lemonspurple/KiCad_STM_Controllerboard_v3_0/Plots/3D.png

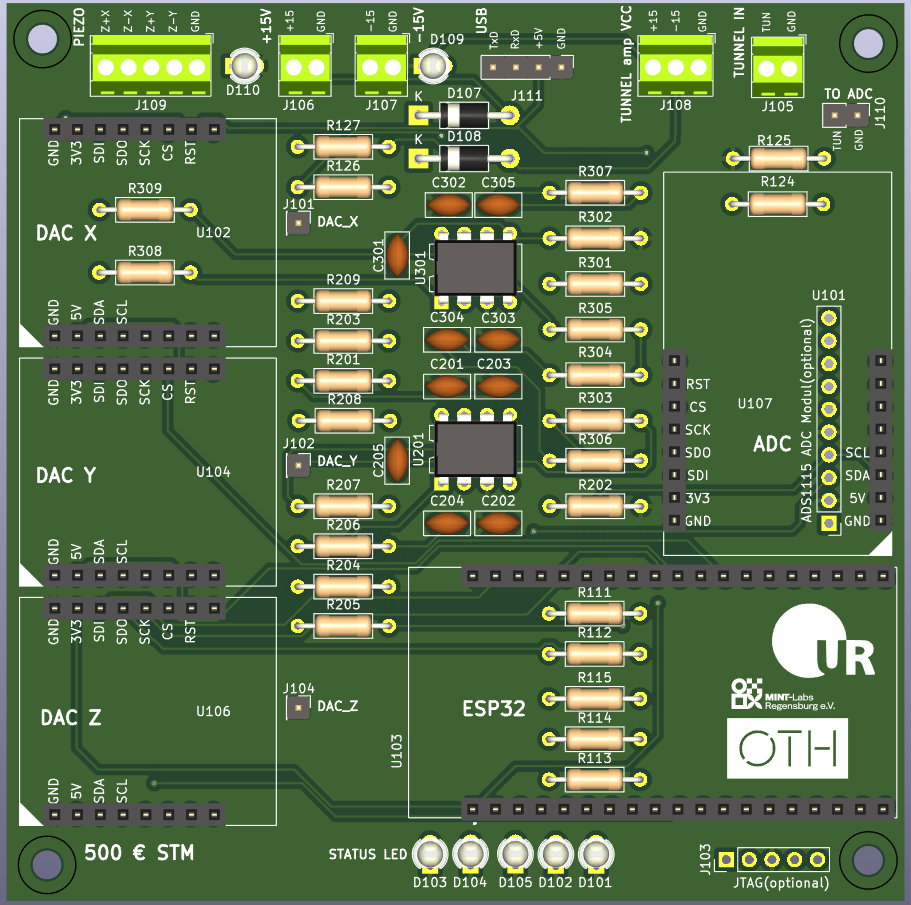
Plots/3D.png
