lemonspurple/KiCad_STM_Controllerboard_v3_0/Plots/FFab.png

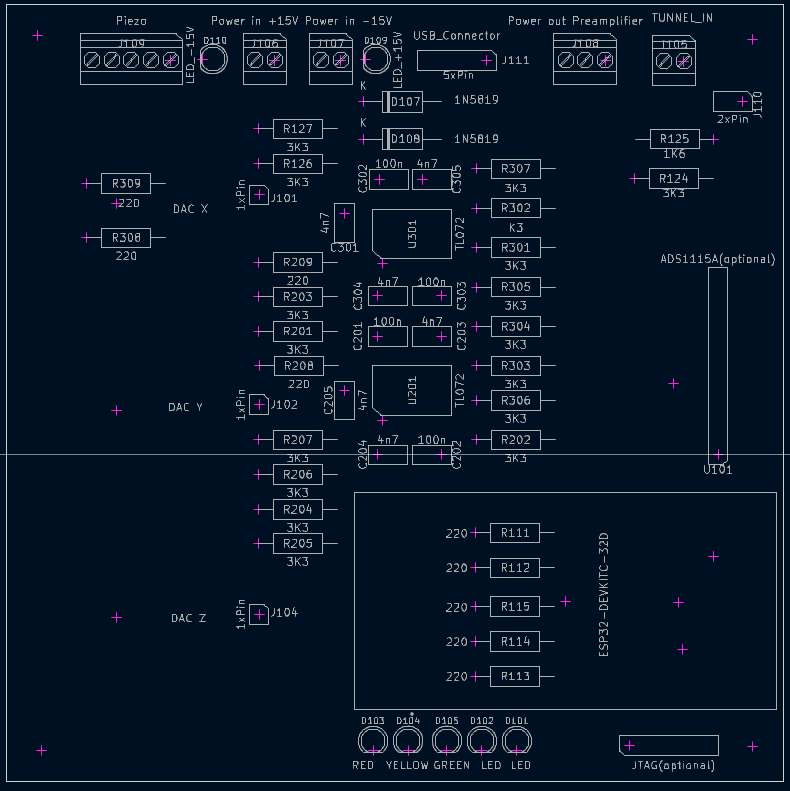
Plots/FFab.png
