lemonspurple/KiCad_STM_Controllerboard_v3_0/Plots/FFab_Fmask.png

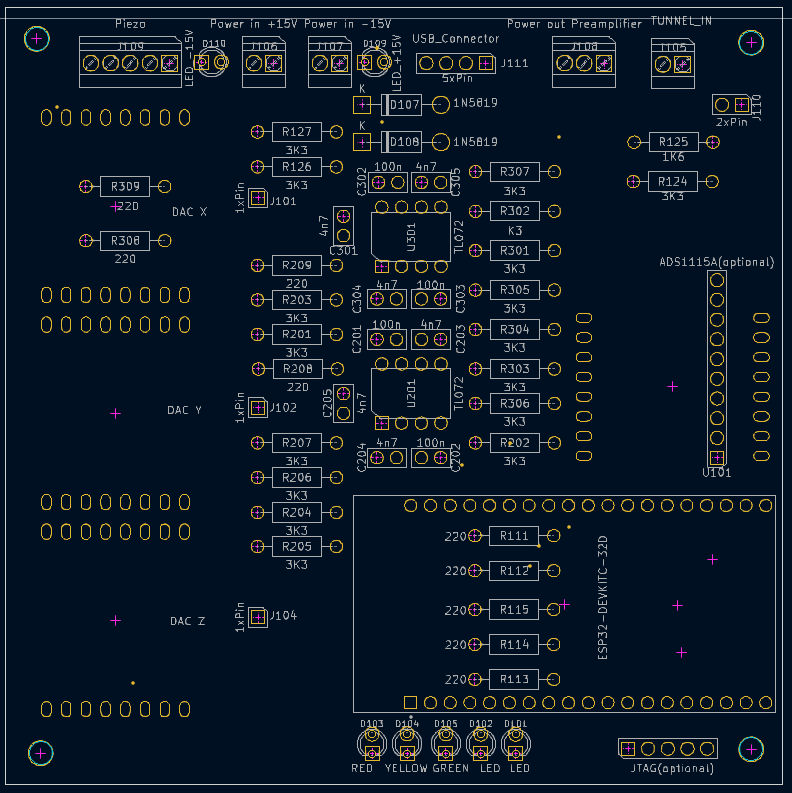
Plots/FFab_Fmask.png
