lemonspurple/KiCad_STM_Controllerboard_v3_0/Plots/Schematics.png

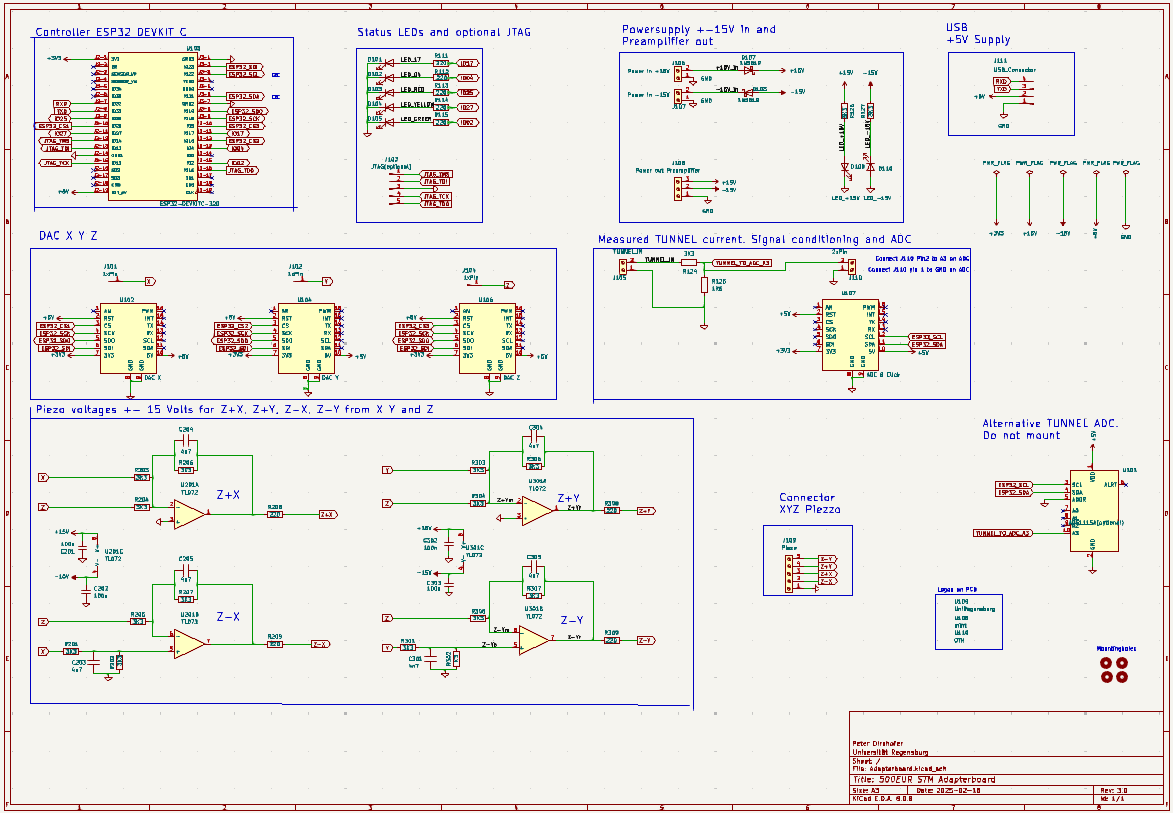
Plots/Schematics.png
