lemonspurple/KiCad_STM_Controllerboard_v3_0/Plots/Silkscreen.png

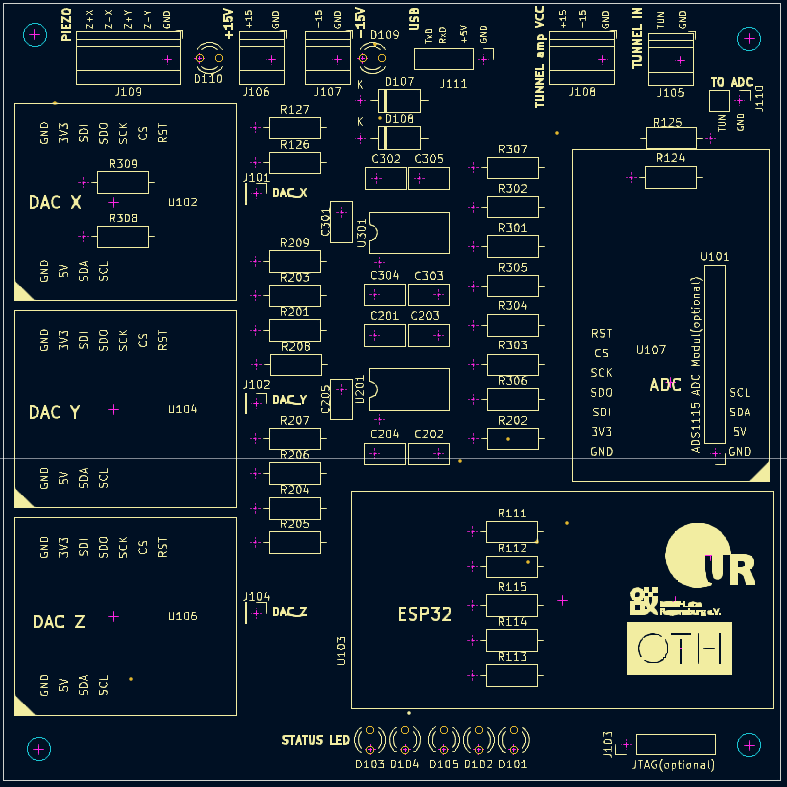
Plots/Silkscreen.png
