lemonspurple/KiCad_STM_Controllerboard_v3_0/Plots/Silkscreen_Fmask.png

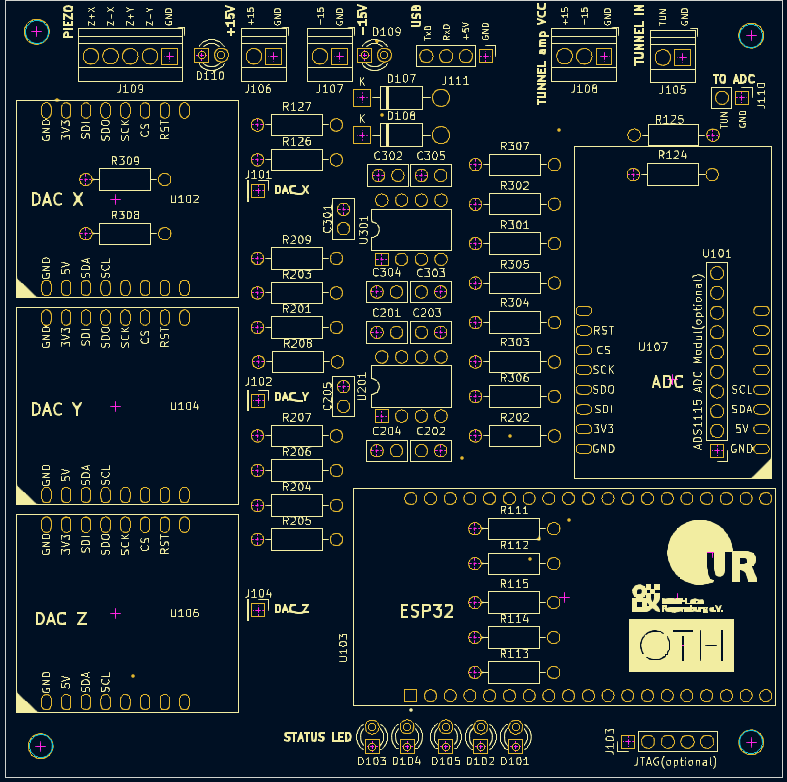
Plots/Silkscreen_Fmask.png
