lemonspurple/KiCad_STM_Controllerboard_v3_0/Adapterboard.pdf

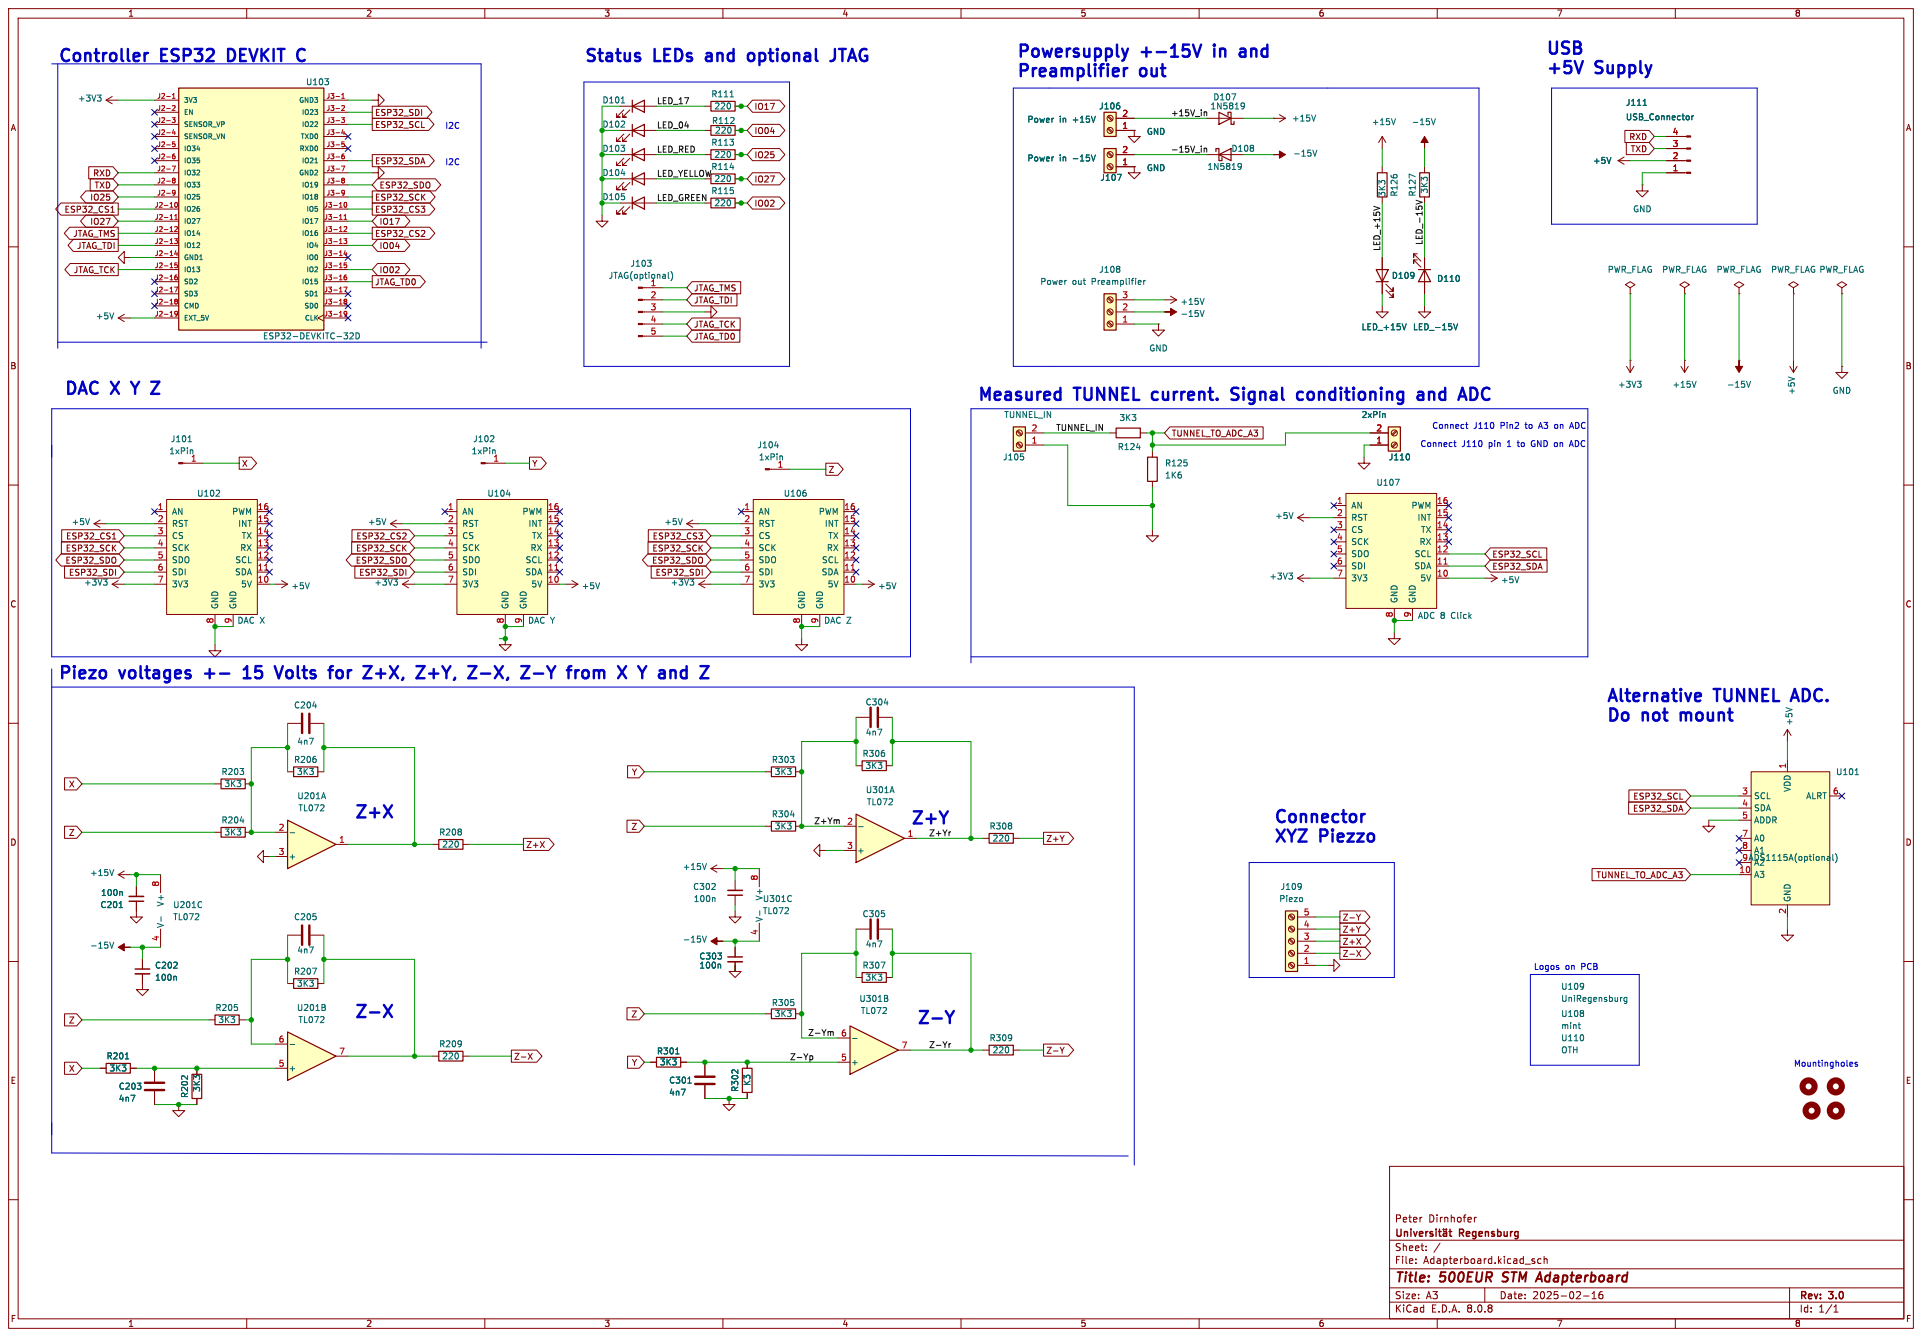
[picture p8: page 1]

Connect J110 Pin2 to A3 on ADC Z-Y

Connect J110 pin 1 to GND on ADC

INT 15 PWM 16 RST 2 CS 3 SCK 4 SDO 5 SDI 6

5V 10 SDA 11 SCL 12 RX 13 TX 14

Id: 1/1 Title: 500EUR STM Adapterboard
