lemonspurple/KiCad_STM_Controllerboard_v3_0/Adapterboard.kicad_pcb

## KiCad design Adapterboard.kicad_pcb (2025-02-21)

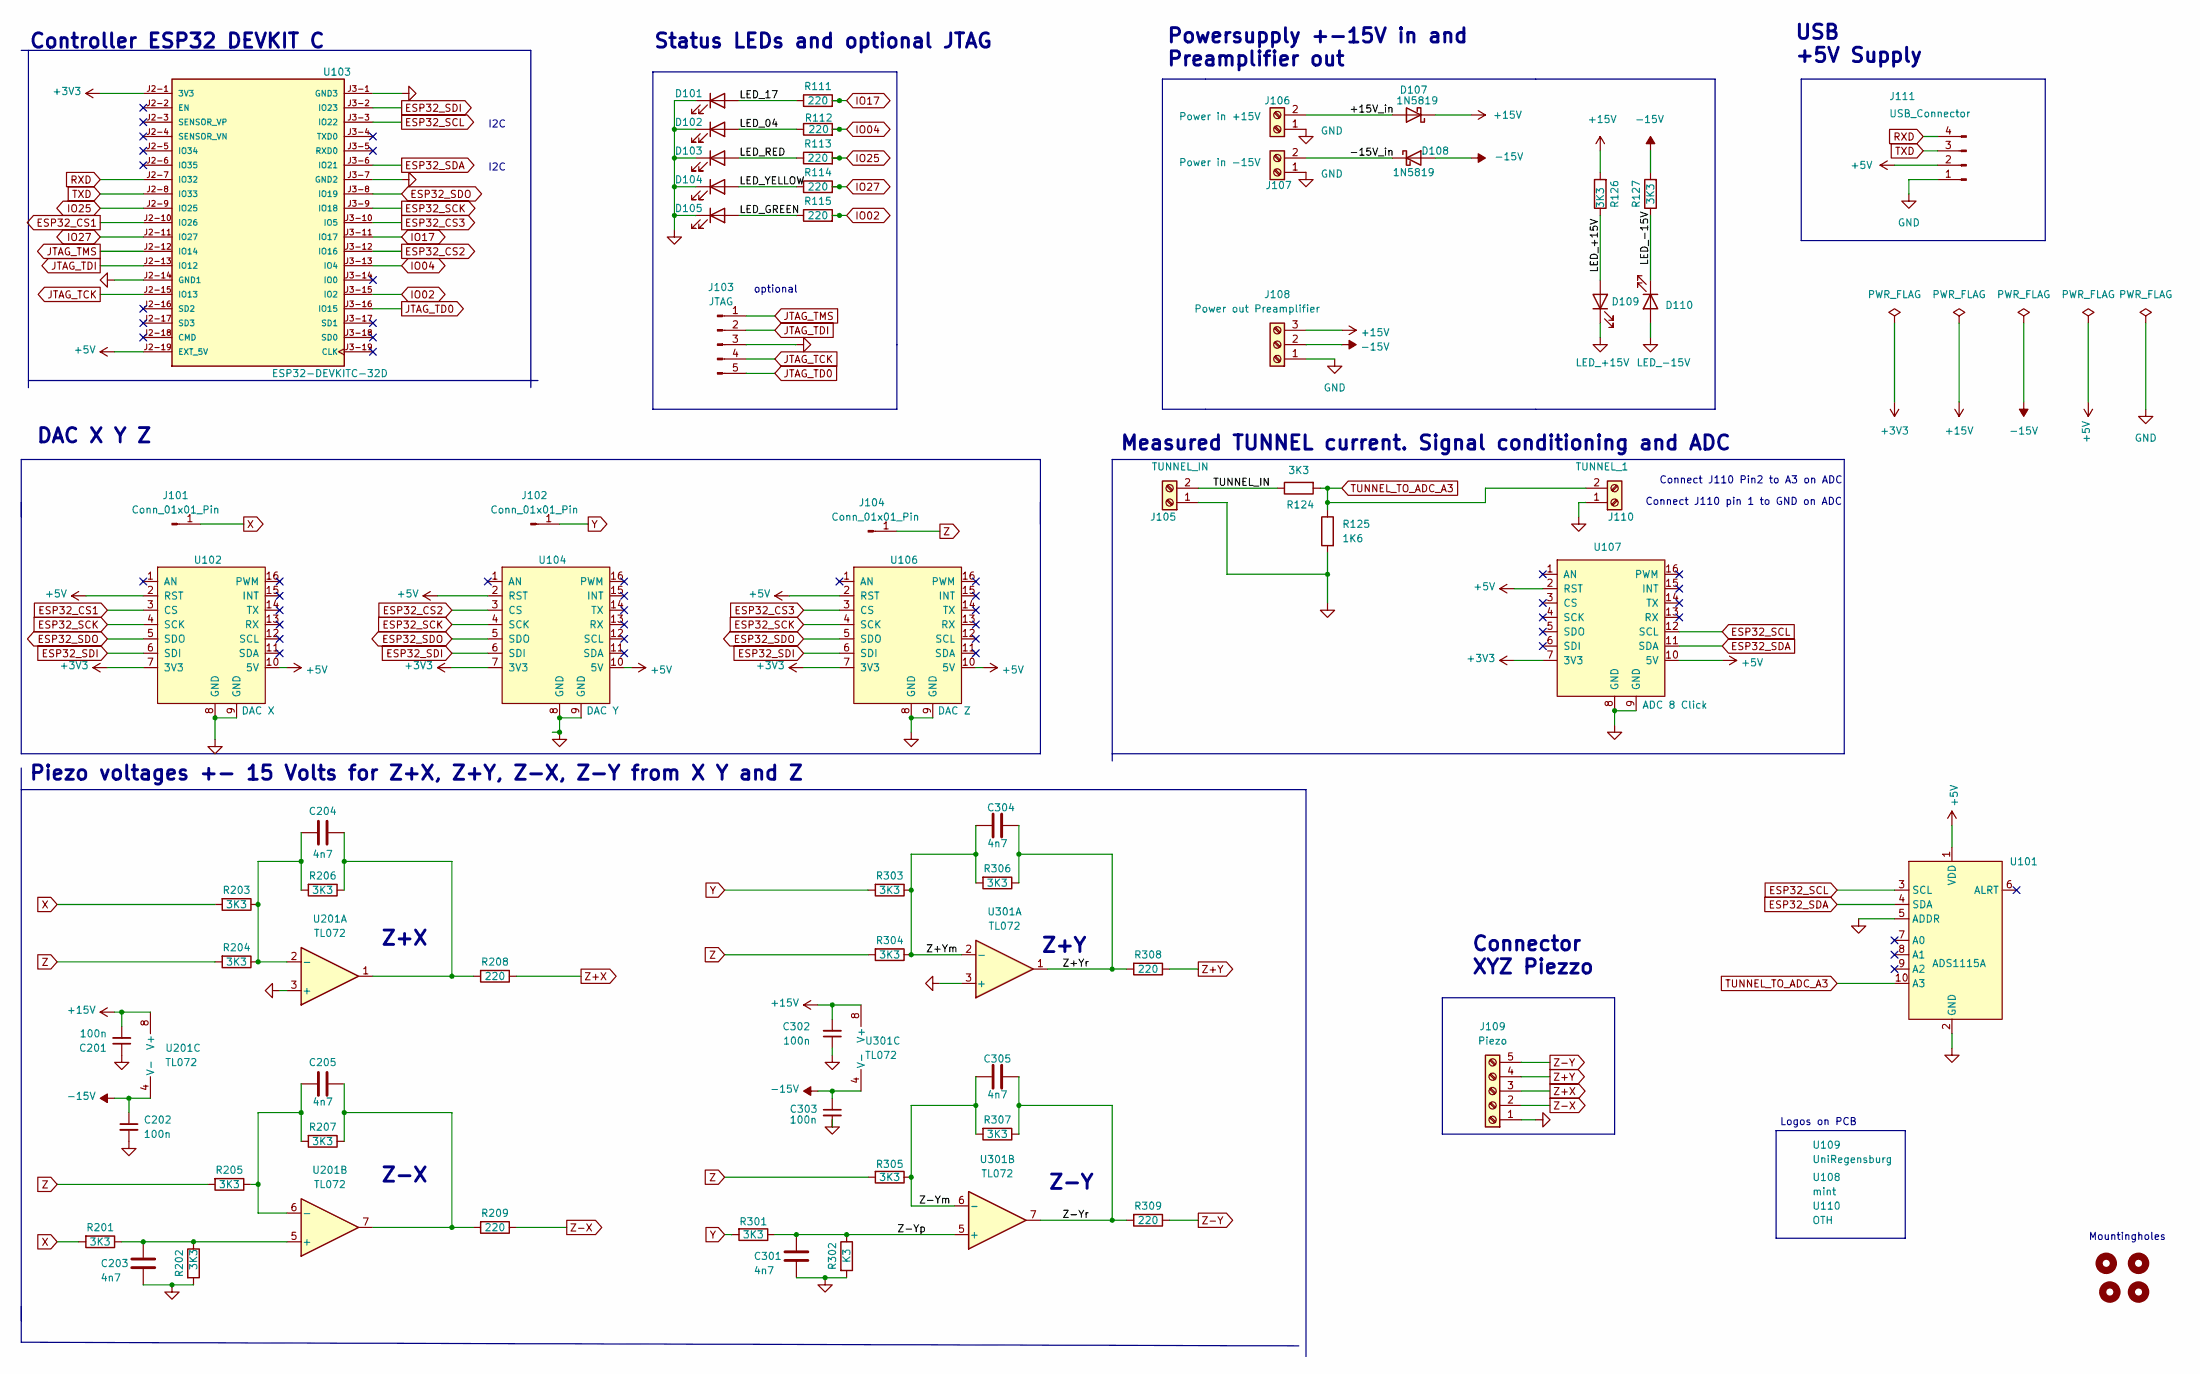
[picture p9: schematic Adapterboard.kicad_sch, 500EUR STM Adapterboard]

Parts:
C201, C202, C302, C303: 100n; C_Disc_D5.0mm_W2.5mm_P2.50mm
C203, C204, C205, C301, C304, C305: 4n7; C_Disc_D5.0mm_W2.5mm_P2.50mm
D101, D102: LED; LED_D3.0mm_Clear
D103: LED_RED; LED_D3.0mm_Clear
D104: LED_YELLOW; LED_D3.0mm_Clear
D105: LED_GREEN; LED_D3.0mm_Clear
D107, D108: 1N5819; D_DO-41_SOD81_P10.16mm_Horizontal
D109: LED_+15V; LED_D3.0mm_Clear
D110: LED_-15V; LED_D3.0mm_Clear
H101, H102, H103, H104: MountingHole; MountingHole_3.2mm_M3
J101, J102, J104: Conn_01x01_Pin; PinHeader_1x01_P2.54mm_Vertical
J103: JTAG; PinHeader_1x05_P2.54mm_Vertical
J105: TUNNEL_IN; TerminalBlock_Xinya_XY308-2.54-2P_1x02_P2.54mm_Horizontal
J106: Power in +15V; TerminalBlock_Xinya_XY308-2.54-2P_1x02_P2.54mm_Horizontal
J107: Power in -15V; TerminalBlock_Xinya_XY308-2.54-2P_1x02_P2.54mm_Horizontal
J108: Power out Preamplifier; TerminalBlock_Xinya_XY308-2.54-3P_1x03_P2.54mm_Horizontal
J109: Piezo; TerminalBlock_Xinya_XY308-2.54-5P_1x05_P2.54mm_Horizontal
J110: TUNNEL_1; PinHeader_1x02_P2.54mm_Vertical
J111: USB_Connector; PinHeader_1x04_P2.54mm_Vertical
R111, R112, R113, R114, R115, R208, R209, R308, R309: 220; R_Axial_DIN0207_L6.3mm_D2.5mm_P10.16mm_Horizontal
R124, R126, R127, R201, R202, R203, R204, R205, R206, R207, R301, R303, R304, R305, R306, R307: 3K3; R_Axial_DIN0207_L6.3mm_D2.5mm_P10.16mm_Horizontal
R125: 1K6; R_Axial_DIN0207_L6.3mm_D2.5mm_P10.16mm_Horizontal
R302: K3; R_Axial_DIN0207_L6.3mm_D2.5mm_P10.16mm_Horizontal
U101: ADS1115A; PinHeader_1x10_P2.54mm_Vertical
U102: DAC X; Mikroe_Socket_DAC_2_Click
U103: ESP32-DEVKITC-32D; MODULE_ESP32-DEVKITC-32D; PARTREV V4
U104: DAC Y; Mikroe_Socket_DAC_2_Click
U106: DAC Z; Mikroe_Socket_DAC_2_Click
U107: ADC 8 Click; Mikroe_Socket_ADC_8_Click
U108: mint
U109: UniRegensburg; ur
U110: OTH; oth
U201, U301: TL072; DIP-8_W7.62mm

Connections:
+3V3: U102.7 (3V3), U103.J2-1 (3V3), U104.7 (3V3), U106.7 (3V3), U107.7 (3V3)
+5V: J111.2, U101.1 (VDD), U102.2 (RST), U102.10 (5V), U103.J2-19 (EXT_5V), U104.2 (RST), U104.10 (5V), U106.2 (RST), U106.10 (5V), U107.2 (RST), U107.10 (5V)
+15V: C201.2, C302.2, D107.1 (K), J108.3, R126.2, U201.8 (V+), U301.8 (V+)
-15V: C202.1, C303.1, D108.2 (A), J108.2, R127.2, U201.4 (V-), U301.4 (V-)
/+15V_in: D107.2 (A), J106.2
/-15V_in: D108.1 (K), J107.2
/LED_04: D102.2 (A), R112.1
/LED_17: D101.2 (A), R111.1
/LED_+15V: D109.2 (A), R126.1
/LED_-15V: D110.1 (K), R127.1
/LED_GREEN: D105.2 (A), R115.1
/LED_RED: D103.2 (A), R113.1
/LED_YELLOW: D104.2 (A), R114.1
/TUNNEL_IN: J105.2, R124.1
/Z+Ym: C304.2, R303.1, R304.1, R306.2, U301.2 (-)
/Z+Yr: C304.1, R306.1, R308.2, U301.1
/Z-Ym: C305.2, R305.1, R307.2, U301.6 (-)
/Z-Yp: C301.1, R301.1, R302.1, U301.5 (+)
/Z-Yr: C305.1, R307.1, R309.2, U301.7
ESP32_CS1: U102.3 (CS), U103.J2-10 (IO26)
ESP32_CS2: U103.J3-12 (IO16), U104.3 (CS)
ESP32_CS3: U103.J3-10 (IO5), U106.3 (CS)
ESP32_SCK: U102.4 (SCK), U103.J3-9 (IO18), U104.4 (SCK), U106.4 (SCK)
ESP32_SCL: U101.3 (SCL), U103.J3-3 (IO22), U107.12 (SCL)
ESP32_SDA: U101.4 (SDA), U103.J3-6 (IO21), U107.11 (SDA)
ESP32_SDI: U102.6 (SDI), U103.J3-2 (IO23), U104.6 (SDI), U106.6 (SDI)
ESP32_SDO: U102.5 (SDO), U103.J3-8 (IO19), U104.5 (SDO), U106.5 (SDO)
GND: C201.1, C202.2, C203.2, C301.2, C302.1, C303.2, D101.1 (K), D102.1 (K), D103.1 (K), D104.1 (K), D105.1 (K), D109.1 (K), D110.2 (A), J103.3, J105.1, J106.1, J107.1, J108.1, J109.1, J110.1, J111.1, R125.2, R202.2, R302.2, U101.2 (GND), U101.5 (ADDR), U102.8 (GND), U102.9 (GND), U103.J2-14 (GND1), U103.J3-1 (GND3), U103.J3-7 (GND2), U104.8 (GND), U104.9 (GND), U106.8 (GND), U106.9 (GND), U107.8 (GND), U107.9 (GND), U201.3 (+), U301.3 (+)
IO02: R115.2, U103.J3-15 (IO2)
IO04: R112.2, U103.J3-13 (IO4)
IO17: R111.2, U103.J3-11 (IO17)
IO25: R113.2, U103.J2-9 (IO25)
IO27: R114.2, U103.J2-11 (IO27)
JTAG_TCK: J103.4, U103.J2-15 (IO13)
JTAG_TD0: J103.5, U103.J3-16 (IO15)
JTAG_TDI: J103.2, U103.J2-13 (IO12)
JTAG_TMS: J103.1, U103.J2-12 (IO14)
unnamed: C204.1, R206.1, R208.2, U201.1
unnamed: C205.1, R207.1, R209.2, U201.7
unnamed: C204.2, R203.1, R204.1, R206.2, U201.2 (-)
unnamed: C203.1, R201.1, R202.1, U201.5 (+)
unnamed: C205.2, R205.1, R207.2, U201.6 (-)
RXD: J111.4, U103.J2-7 (IO32)
TUNNEL_TO_ADC_A3: J110.2, R124.2, R125.1, U101.10 (A3)
TXD: J111.3, U103.J2-8 (IO33)
X: J101.1, R201.2, R203.2
Y: J102.1, R301.2, R303.2
Z: J104.1, R204.2, R205.2, R304.2, R305.2
Z+X: J109.3, R208.1
Z+Y: J109.4, R308.1
Z-X: J109.2, R209.1
Z-Y: J109.5, R309.1

Notes on the sheet:
Measured TUNNEL current. Signal conditioning and ADC
Connector XYZ Piezzo
Status LEDs and optional JTAG
I2C
Z-Y
USB +5V Supply
optional
Powersupply +-15V in and Preamplifier out
Controller ESP32 DEVKIT C
Connect J110 pin 1 to GND on ADC
Mountingholes
Piezo voltages +- 15 Volts for Z+X, Z+Y, Z-X, Z-Y from X Y and Z
Connect J110 Pin2 to A3 on ADC
Logos on PCB
DAC X Y Z
Z-X
Z+X
Z+Y

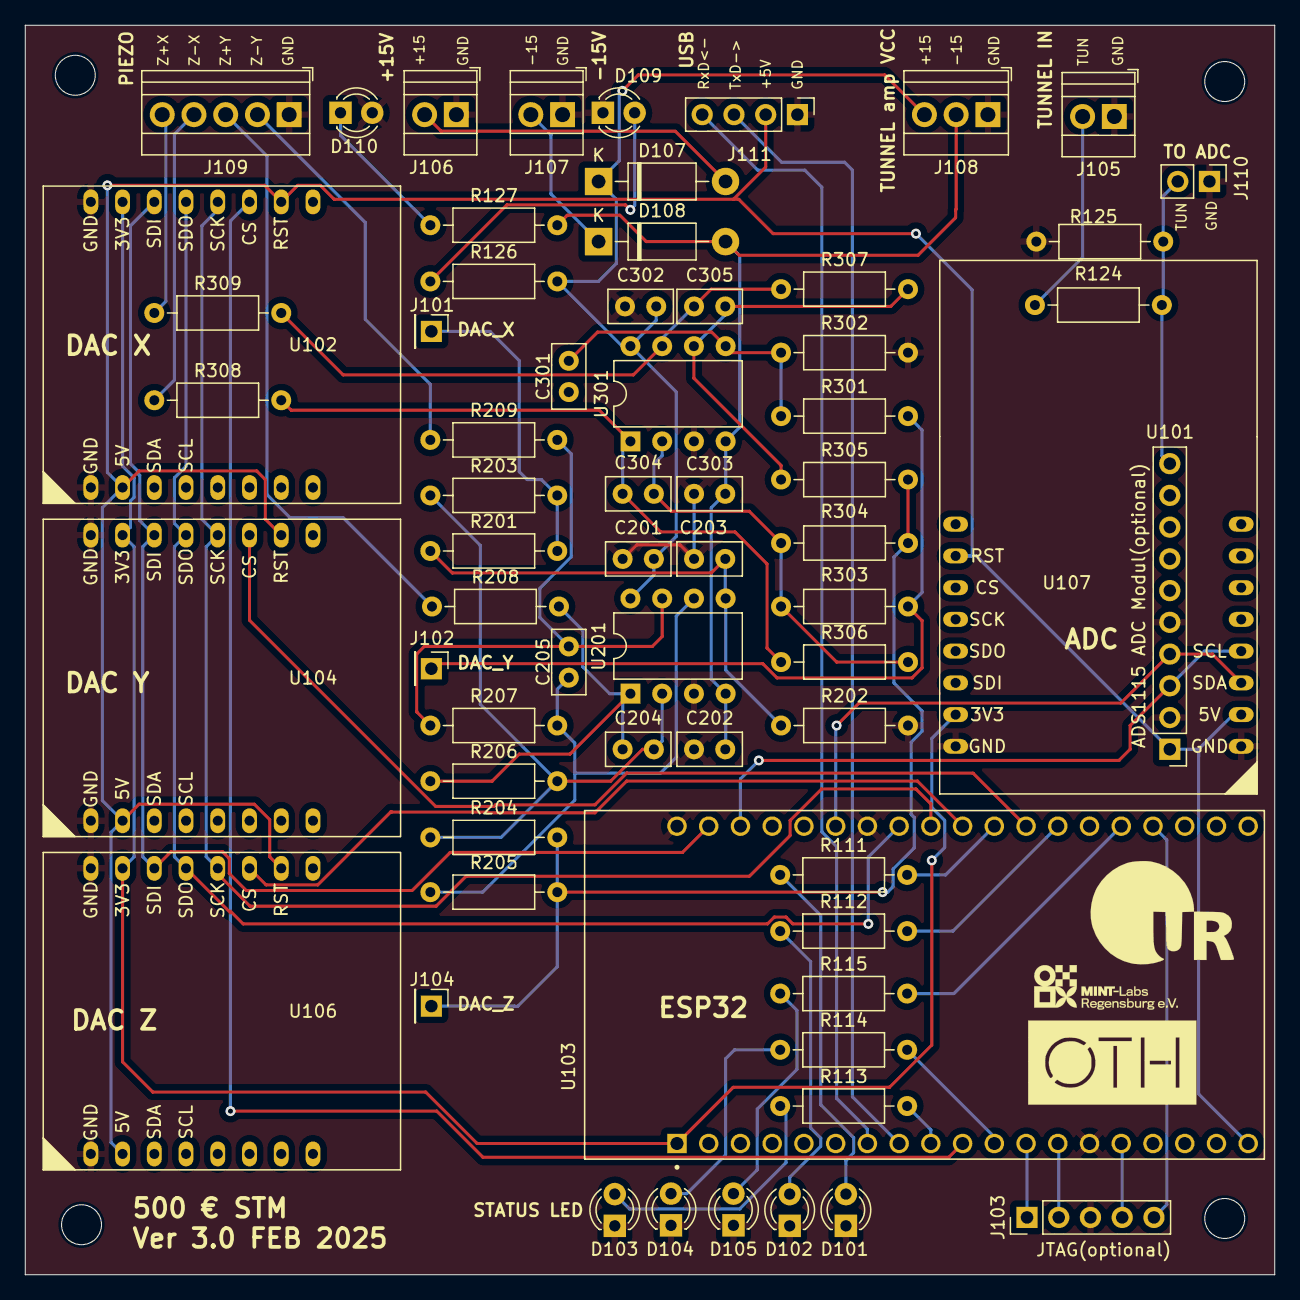
[picture p10: board Adapterboard.kicad_pcb from above]

Board: 2 copper layers, 100.0 x 100.0 mm, 72 parts (0 on the bottom side), 52 nets.
