lemonspurple/KiCad_STM_Controllerboard_v3_0/(commit log)

2025-02-19 complete for production
    [Adapterboard.kicad_pcb, Adapterboard.kicad_sch]
2025-02-19 ADS1115 added
    [Adapterboard.kicad_pcb, Adapterboard.kicad_sch]
2025-02-21 Plots added
    [Adapterboard.kicad_pcb]
2025-02-21 schematics plot added
2026-01-19 Redid the gerber files and added .zip for convenience
    [Adapterboard-B_Courtyard.gbr, Adapterboard-B_Cu.gbr, Adapterboard-B_Fab.gbr, Adapterboard-B_Mask.gbr, Adapterboard-Edge_Cuts.gbr, Adapterboard-F_Courtyard.gbr, Adapterboard-F_Cu.gbr, Adapterboard-F_Fab.gbr]
